marangisto/LFO/Transparent.png

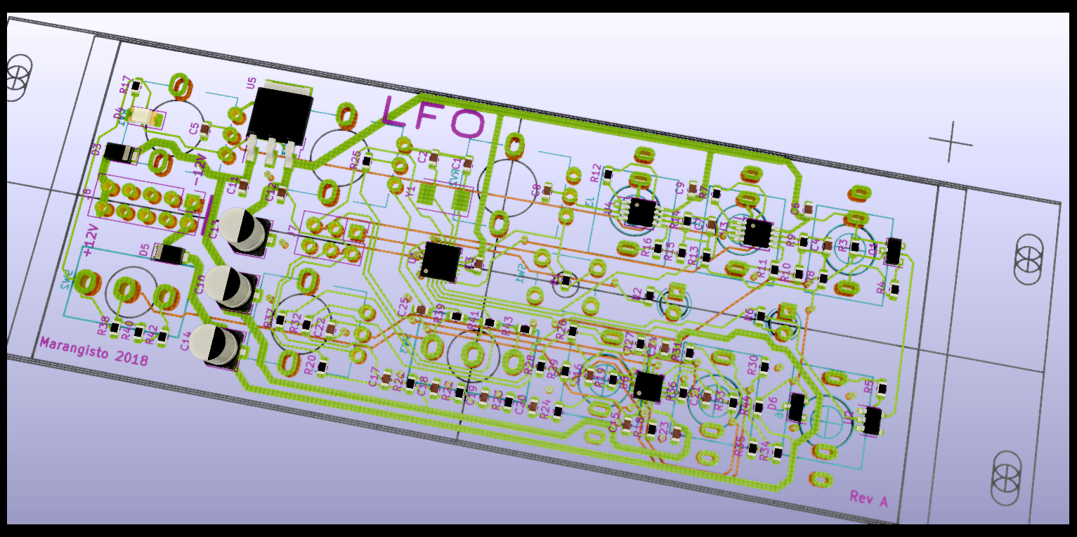
Transparent.png
