marangisto/LFO/Front.png

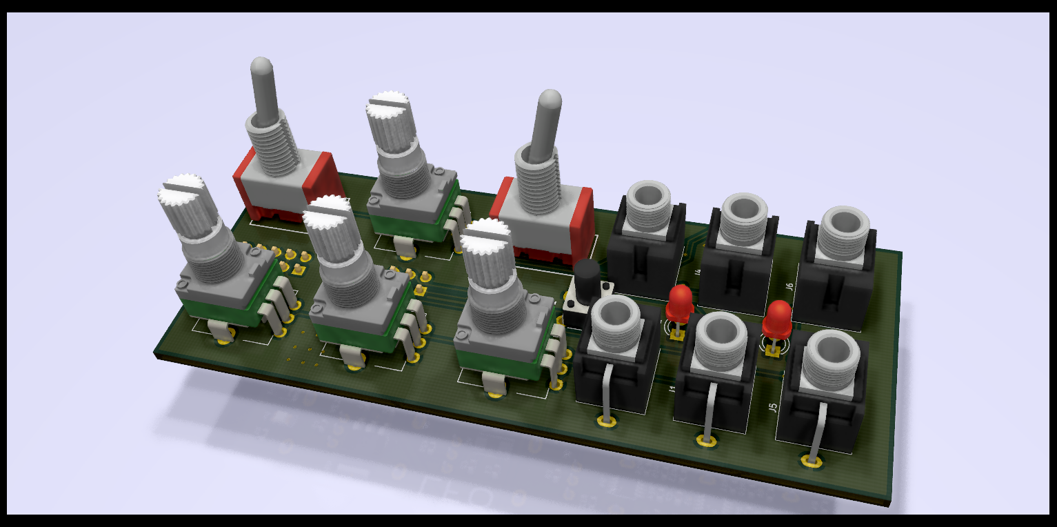
Front.png
