marangisto/LFO/Back.png

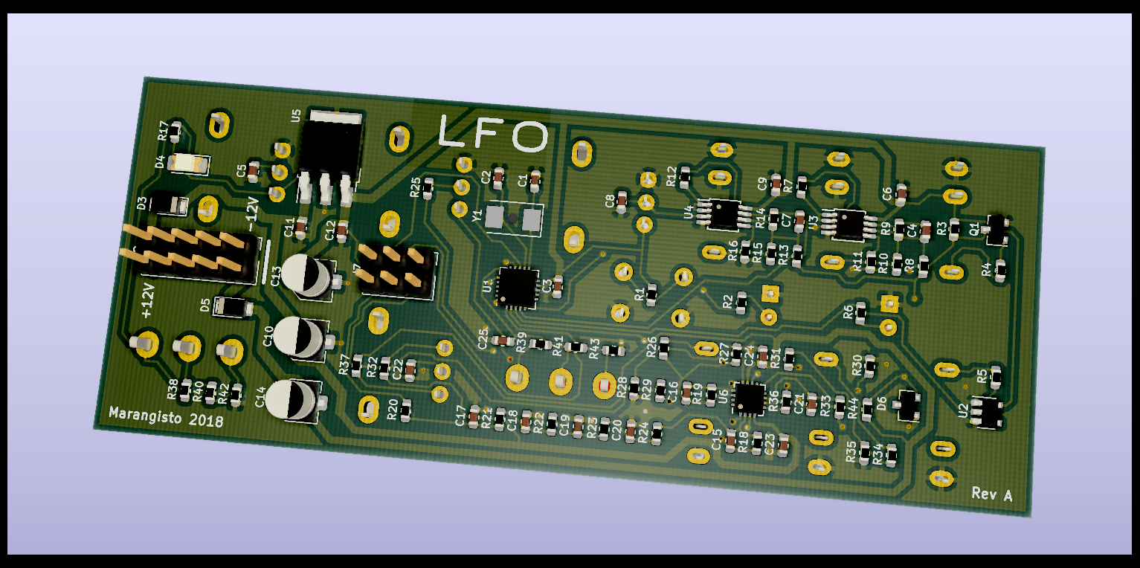
Back.png
