marangisto/LFO/Decoder.png

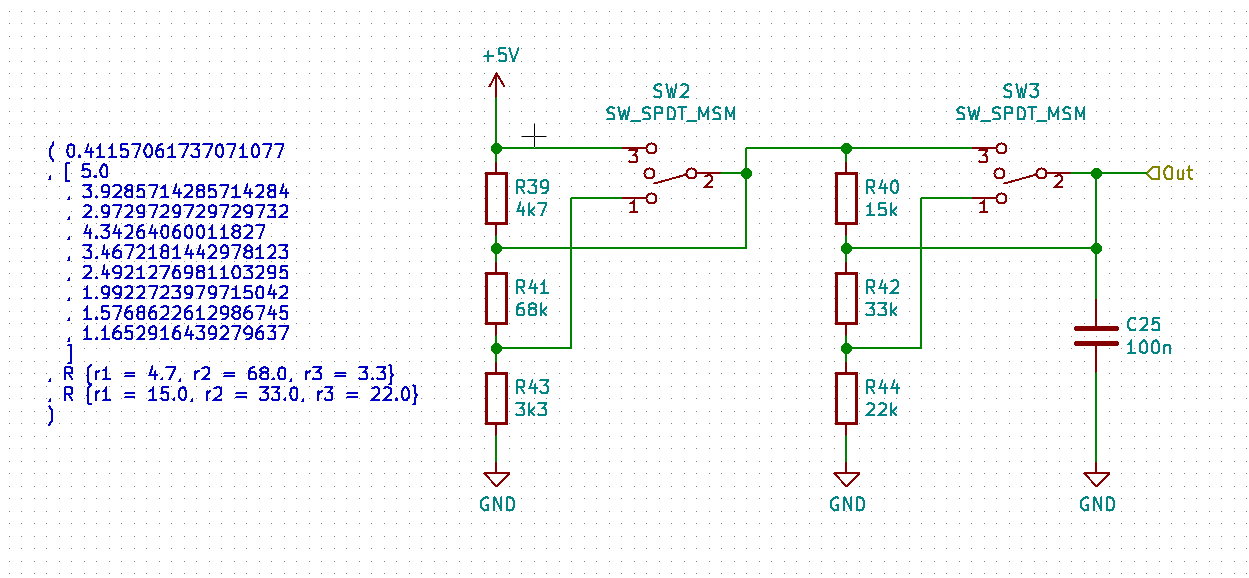
Decoder.png
