marangisto/LFO/render-rev-b.png

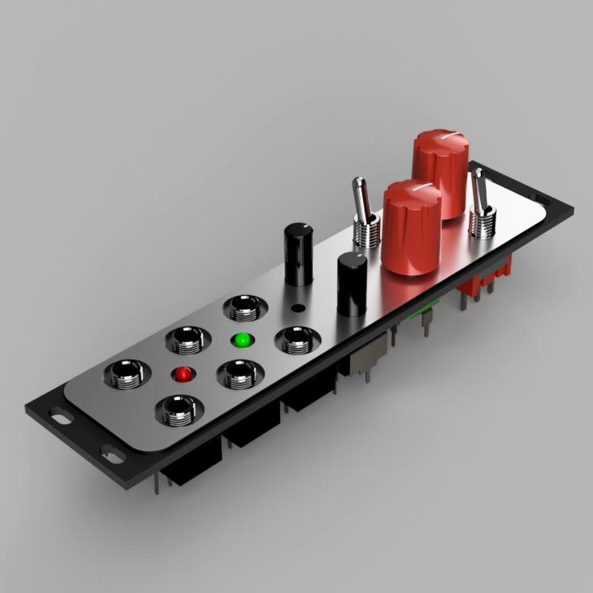
render-rev-b.png
