marangisto/LFO/edgecuts.dxf

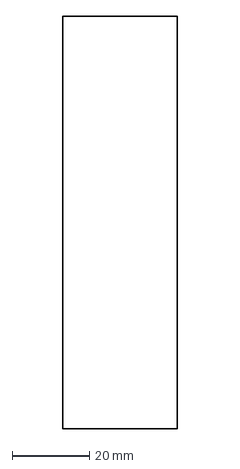
[picture p6: CAD file, 2019-03-26]
edgecuts.dxf
29.5 x 106.5 mm
