marangisto/LFO/drawing.dxf

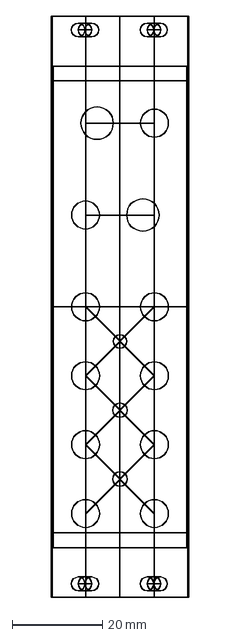
[picture p7: CAD file, 2019-03-26]
drawing.dxf
30.5 x 128.6 mm
