marangisto/LFO/LFO.kicad_pcb

## KiCad design LFO.kicad_pcb (2019-04-14)

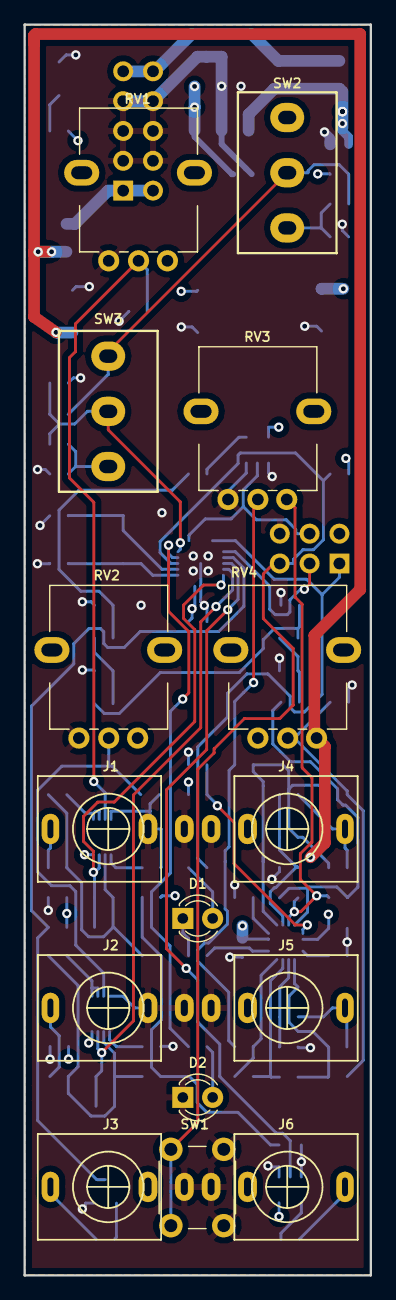
[picture p8: board LFO.kicad_pcb from above]

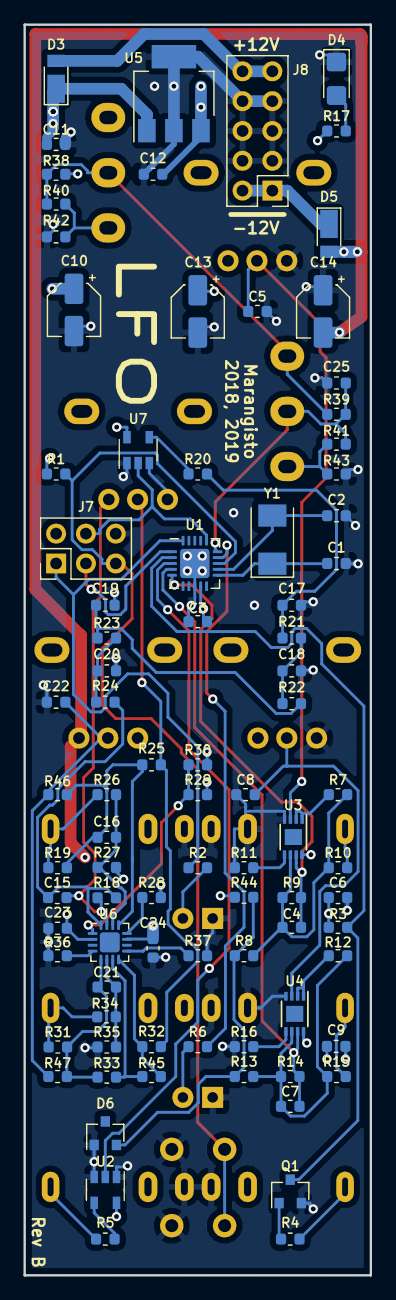
[picture p9: board LFO.kicad_pcb from below]

Board: 4 copper layers, 29.5 x 106.5 mm, 102 parts (87 on the bottom side), 60 nets.

Parts:
C1, C2: 22p; C_0603_1608Metric
C3, C5, C6, C8, C9, C11, C12, C22, C23, C24, C25: 100n; C_0603_1608Metric
C4, C7: 470p; C_0603_1608Metric
C10, C13, C14: 10u; CP_Elec_4x5.8
C15, C16, C21: 100p; C_0603_1608Metric
C17, C18, C19, C20: 47n; C_0603_1608Metric
D1, D2: LED; LED_D3.0mm
D3, D5: DFLR1400-7; D_PowerDI-123
D4: LED; LED_1206_3216Metric_Castellated
D6: LM4040DBZ-10; SOT-23
J1, J2, J3, J4, J5, J6: AudioJack2_SwitchT; PJ398SM
J7: Conn_02x03_Odd_Even; PinHeader_2x03_P2.54mm_Vertical
J8: Conn_02x05_Odd_Even; PinHeader_2x05_P2.54mm_Vertical
Q1: BC847; SOT-23
R1, R3, R30: 10k; R_0603_1608Metric
R2, R6, R17: 330; R_0603_1608Metric
R4, R7, R9, R12, R14, R15, R19, R25, R27, R31, R32, R33, R35, R45: 100k; R_0603_1608Metric
R5, R26, R34: 1k; R_0603_1608Metric
R8, R10, R13: 200k; R_0603_1608Metric
R11, R16, R28, R36, R37: 47k; R_0603_1608Metric
R18, R40: 68k; R_0603_1608Metric
R20, R21, R22, R23: 470; R_0603_1608Metric
R24, R41: 33k; R_0603_1608Metric
R29: 20k; R_0603_1608Metric
R38: 4k7; R_0603_1608Metric
R39: 15k; R_0603_1608Metric
R42: 3k3; R_0603_1608Metric
R43: 22k; R_0603_1608Metric
R44: 2k2; R_0603_1608Metric
R46, R47: 220k; R_0603_1608Metric
RV1, RV3: 100k; AlpsRK09K
RV2, RV4: 100k; R09M3KT
SW1: SW_Push; SW_PUSH_6mm_H9.5mm
SW2, SW3: SW_SPDT_MSM; SPDT
U1: ATtiny84-20MU; QFN-20-1EP_4x4mm_P0.5mm_EP2.5x2.5mm
U2, U7: 74AHCT1G125; SOT-23-5
U3, U4: MCP6002-xMS; DFN-8-1EP_3x2mm_P0.5mm_EP1.36x1.46mm
U5: L7805; SOT-223-3_TabPin2
U6: LM324QT; QFN-16-1EP_3x3mm_P0.5mm_EP1.7x1.7mm
Y1: 20MHz; Crystal_SMD_Abracon_ABM3-2Pin_5.0x3.2mm

Connections:
+5V: C3.1, C6.1, C9.1, C12.1, C13.1, J3.TN, J7.2, R1.1, R3.1, R17.1, R29.2, R38.1, RV1.1, RV2.1, SW2.3, U1.9, U2.5, U3.8, U4.8, U5.3, U7.5
+12V: C10.1, C11.1, C23.1, D3.1, RV4.3, U5.1, U6.2
-12V: C14.2, C24.2, D5.2, R44.1, RV4.1, U6.11
/CVIn05.sch/In: J2.T, R15.1
/CVIn55/In: J1.T, R10.1
/DigitalIn/In: J3.T, R4.1
/DigitalOut/Out: J6.T, R5.1
/OutputStage/Inv: J5.T, R31.1, R34.1
/OutputStage/Out: J4.T, R19.1, R26.1
FREQ: C4.1, R9.1, U1.5, U3.7
GND: C1.1, C2.1, C3.2, C5.2, C6.2, C8.2, C9.2, C10.2, C11.2, C12.2, C13.2, C14.1, C17.2, C18.2, C19.2, C20.2, C22.2, C23.2, C24.1, C25.2, D1.1, D2.1, D4.1, D6.1, J1.S, J1.TN, J2.S, J2.TN, J3.S, J4.S, J5.S, J6.S, J7.6, J8.3, J8.4, J8.5, J8.6, J8.7, J8.8, Q1.2, R11.2, R16.2, R27.2, R28.1, R30.1, R35.2, R36.1, R37.1, R42.2, R43.2, RV1.3, RV2.3, RV3.3, SW1.2, U1.8, U1.21, U2.1, U2.3, U3.4, U4.4, U5.2, U7.1, U7.3
LED1: J7.1, R2.1, U1.20
LED2: R6.1, U1.14
MOSI: J7.4, U1.16, U7.2
unnamed: C1.2, U1.11, Y1.1
unnamed: C2.2, U1.12, Y1.2
unnamed: C4.2, R7.2, R8.2, R9.2, R10.2, U3.6
unnamed: C5.1, RV1.2, U3.3
unnamed: C7.2, R12.2, R13.2, R14.2, R15.2, U4.6
unnamed: C8.1, RV2.2, U4.3
unnamed: C15.1, R18.1, RV3.1, U6.15
unnamed: C15.2, R18.2, R24.1, U6.16
unnamed: C16.1, R26.2, R27.1, U6.14
unnamed: C16.2, R19.2, R25.2, R46.2, U6.13
unnamed: C17.1, R20.1, R21.2
unnamed: C18.1, R21.1, R22.2
unnamed: C19.1, R22.1, R23.2
unnamed: C20.1, R23.1, R24.2
unnamed: C21.1, R34.2, R35.1, U6.6
unnamed: C21.2, R31.2, R33.2, R47.2, U6.5
unnamed: C22.1, R46.1, R47.1, RV4.2
unnamed: D1.2, R2.2
unnamed: D2.2, R6.2
unnamed: D3.2, J8.9, J8.10
unnamed: D4.2, R17.2
unnamed: D5.1, J8.1, J8.2
unnamed: Q1.1, R4.2
unnamed: R5.2, U2.4
unnamed: R7.1, U3.1, U3.2
unnamed: R11.1, U3.5
unnamed: R12.1, U4.1, U4.2
unnamed: R16.1, U4.5
unnamed: R25.1, R32.2, RV3.2
unnamed: R28.2, U6.12
unnamed: R29.1, R30.2, U6.1
unnamed: R32.1, R45.2, U6.8
unnamed: R33.1, R45.1, U6.7
unnamed: R36.2, U6.4
unnamed: R37.2, U6.9
unnamed: R38.2, R39.1, R40.1, SW2.2, SW3.3
unnamed: R40.2, R42.1, SW2.1
unnamed: R41.2, R43.1, SW3.1
OUT: R20.2, U7.4
PWM: C7.1, R14.1, U1.4, U4.7
RESET: J7.5, R1.2, SW1.1, U1.13
SCK: J7.3, U1.1
SPDTS: C25.1, R39.2, R41.1, SW3.2, U1.15
SYNC: Q1.3, R3.2, U1.2
TRIG: U1.3, U2.2
VRef-10: D6.2, R8.1, R13.1, R44.2
