marangisto/LFO/(commit log)

2018-12-26 Initial LFO project.
    [LFO.kicad_pcb, LFO.sch]
2018-12-27 Draft schematic design.
    [CVIn05.sch, CVIn55.sch, DigitalIn.sch, DigitalOut.sch, LFO.sch, POW5V.sch]
2018-12-29 Added decoder function (with zero secondary current draw assumption).
2018-12-29 Decode with complete circuit.
2018-12-29 Output stage and switches.
    [CVIn05.sch, CVIn55.sch, DigitalIn.sch, DigitalOut.sch, DualSW.sch, LFO.sch, OutputStage.sch, POW5V.sch]
2018-12-29 Added missing cap on switch circuit.
    [DualSW.sch]
2018-12-30 LED2 assignment and keep high sync when unconnected.
    [LFO.sch]
2018-12-30 Footprints and adjustments.
    [CVIn05.sch, CVIn55.sch, DigitalIn.sch, DigitalOut.sch, DualSW.sch, LFO.sch, OutputStage.sch, POW5V.sch]
2018-12-30 Added local footprint library.
2018-12-30 Upgraded to KiCad 5.02 and set footprints.
    [CVIn05.sch, CVIn55.sch, DigitalIn.sch, DigitalOut.sch, LFO.sch, POW5V.sch]
2018-12-30 Board geometry.
    [LFO.kicad_pcb, drawing.dxf, edgecuts.dxf]
2018-12-30 Initial placement.
    [DigitalOut.sch, LFO.kicad_pcb, LFO.sch, OutputStage.sch, POW5V.sch]
2018-12-30 Updated footprint library.
    [CVIn05.sch, CVIn55.sch, DigitalIn.sch, DigitalOut.sch, DualSW.sch, LFO.kicad_pcb, LFO.sch, OutputStage.sch]
2018-12-30 First complete placement.
    [CVIn05.sch, CVIn55.sch, DigitalIn.sch, DigitalOut.sch, DualSW.sch, LFO.kicad_pcb, LFO.sch, OutputStage.sch]
2018-12-30 Better orientation of op-amp.
    [LFO.kicad_pcb, OutputStage.sch]
2018-12-30 Manually routed power.
    [LFO.kicad_pcb, LFO.sch]
2018-12-30 Autorouted signals and manual pours and adjustments.
    [LFO.kicad_pcb]
2018-12-31 Added keepouts for jacks.
    [LFO.kicad_pcb]
2018-12-31 Front silk-screen.
    [LFO.kicad_pcb]
2018-12-31 Back silk-screen.
    [LFO.kicad_pcb]
2018-12-31 Added missing files.
    [VRef-10.sch]
2018-12-31 Added Gerbers.
    [LFO-B.Cu.gbr, LFO-B.Mask.gbr, LFO-B.Paste.gbr, LFO-B.SilkS.gbr, LFO-Edge.Cuts.gbr, LFO-F.Cu.gbr, LFO-F.Mask.gbr, LFO-F.SilkS.gbr]
2018-12-31 Added BOM.
    [LFO.csv]
2019-02-19 Added sheet for switch decoder table.
    [Decoder.xlsx]
2019-03-02 Updated calibrated spdts levels.
    [Decoder.xlsx]
2019-03-03 Corrected pin-assignments on new symbol.
2019-03-03 Use correct symbol for LM324QT.
    [CVIn05.sch, CVIn55.sch, DigitalIn.sch, DigitalOut.sch, DualSW.sch, LFO.sch, OutputStage.sch, POW5V.sch]
2019-03-09 Added sheet to compute frequency tables for firmare.
    [Frequency.xlsx]
2019-03-10 Redesigned output stage for proper handling of offset.
    [CVIn05.sch, CVIn55.sch, DigitalIn.sch, DigitalOut.sch, DualSW.sch, LFO.sch, OutputStage.sch, POW5V.sch]
2019-03-10 Minor adjustments to output stage.
    [CVIn05.sch, CVIn55.sch, DigitalIn.sch, DigitalOut.sch, DualSW.sch, LFO.sch, OutputStage.sch, POW5V.sch]
2019-03-23 Upgraded to KiCad 5.1 and added programming jumper.
    [CVIn05.sch, CVIn55.sch, DigitalIn.sch, DigitalOut.sch, DualSW.sch, LFO.sch, OutputStage.sch, POW5V.sch]
2019-03-23 Moved LED1 to PA5 (PWM capable) and LED2 to PB2 for separate control.
    [DigitalIn.sch, DigitalOut.sch, LFO.sch]
2019-03-24 Use new package for LM324QT.
    [OutputStage.sch]
2019-03-24 Added footprint and 3-d model for R09M3KT pots.
2019-03-26 Added buffer on PWM out and changed footprints for MCP6002 and 7805 for smaller size.
    [CVIn05.sch, CVIn55.sch, DigitalOut.sch, LFO.sch, POW5V.sch]
2019-03-26 New drawing and edgecuts for new layout.
    [drawing.dxf, edgecuts.dxf]
2019-04-01 Initial placement and power.
    [CVIn05.sch, LFO.kicad_pcb, OutputStage.sch]
2019-04-02 Some minor placement adjustments.
    [LFO.kicad_pcb]
2019-04-02 Removed old gerbers.
    [LFO-B.Cu.gbr, LFO-B.Mask.gbr, LFO-B.Paste.gbr, LFO-B.SilkS.gbr, LFO-Edge.Cuts.gbr, LFO-F.Cu.gbr, LFO-F.Mask.gbr, LFO-F.SilkS.gbr]
2019-04-03 Completed 4-layer routing.
    [LFO.kicad_pcb]
2019-04-08 Autorouted 2-layer version but no power routing done.
    [LFO.kicad_pcb]
2019-04-14 Revert "Autorouted 2-layer version but no power routing done."
    This reverts commit d698285758b8106e3bcfe68091c579182fce5db9.
    [LFO.kicad_pcb]
2019-04-14 Added top and bottom pours.
    [LFO.kicad_pcb]
2019-04-14 Moved a resistor for better routing.
    [LFO.kicad_pcb]
2019-04-14 Ground vias for MCU.
    [LFO.kicad_pcb]
2019-04-14 Double power vias.
    [LFO.kicad_pcb]
2019-04-14 Updated gerbers for rev B.
    [LFO-B.Cu.gbr, LFO-B.Mask.gbr, LFO-B.Paste.gbr, LFO-B.SilkS.gbr, LFO-Edge.Cuts.gbr, LFO-F.Cu.gbr, LFO-F.Mask.gbr, LFO-F.SilkS.gbr]
2019-05-05 Led2 to follow trigger output.
2019-05-05 Led-1 on pwm channel b.
2019-05-05 Led1 pwm is not inverted.
    [Main.cpp]
2019-05-05 Reset on range changes to avoid lock-up on slow speed.
    [Main.cpp]
2019-05-05 Corrected direction for led1.
    [Main.cpp]
2019-05-05 Added sync interrupt reset.
    [Main.cpp]
